choicebuilds/Kamii/README.md

# SumoBot v2
A significantly improved version of [SumoBot v1](https://github.com/choicebuilds/SumoBot-v1)!  Concise documentation intended as a project showcase for my portfolio/resume.
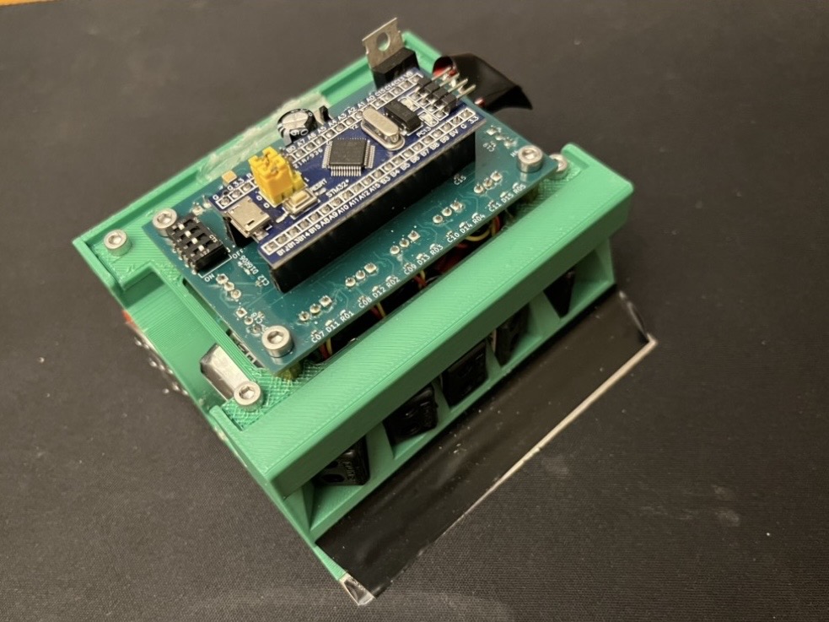
[picture p1: pictures/final_bot.jpg]
SumoBot
  
Notable Improvements:
- 4-layer PCB with dedicated 9V/5V planes and a solid ground plane to improve return current paths and help reduce EMI
- Decoupling & bulk capacitors placed throughout the board for improved power integrity
- STM32 MCU + STM32CubeMX + C/Cmake Firmware
- Various quality of life additions (e.g. strategy switch, remote start, on/off switch, etc.)
- Compact layout featuring 0402 surface-mount components (ft. dog-bone fanout for motor drivers for space and cost)
 
## Hardware Showcase
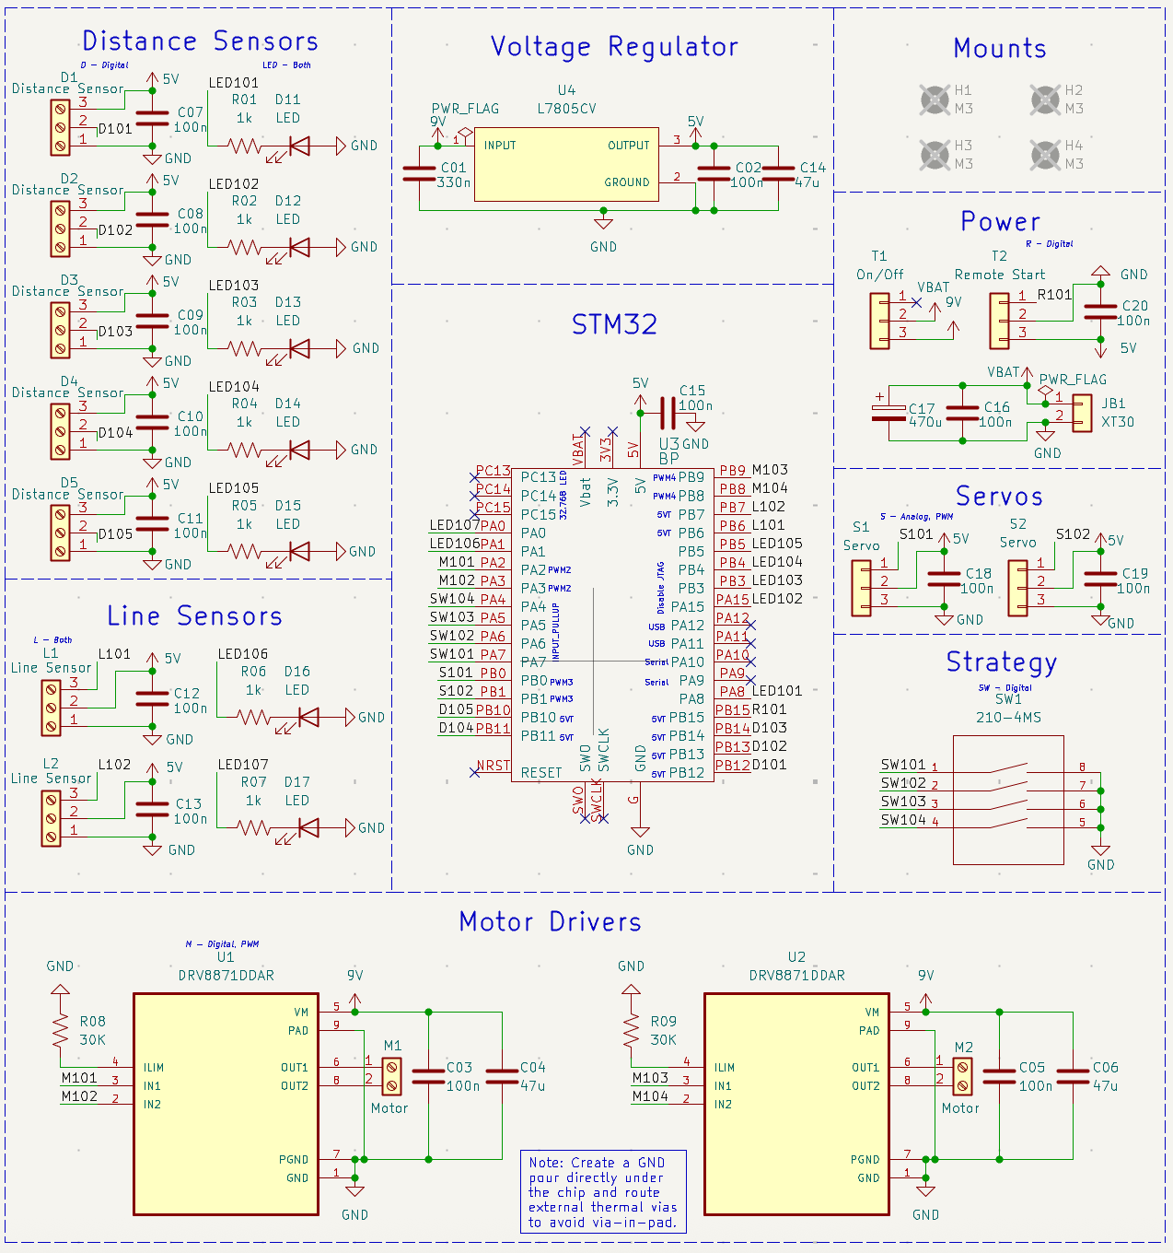
[picture p2: pictures/Kamikazii-Schematic.png]
Schematic


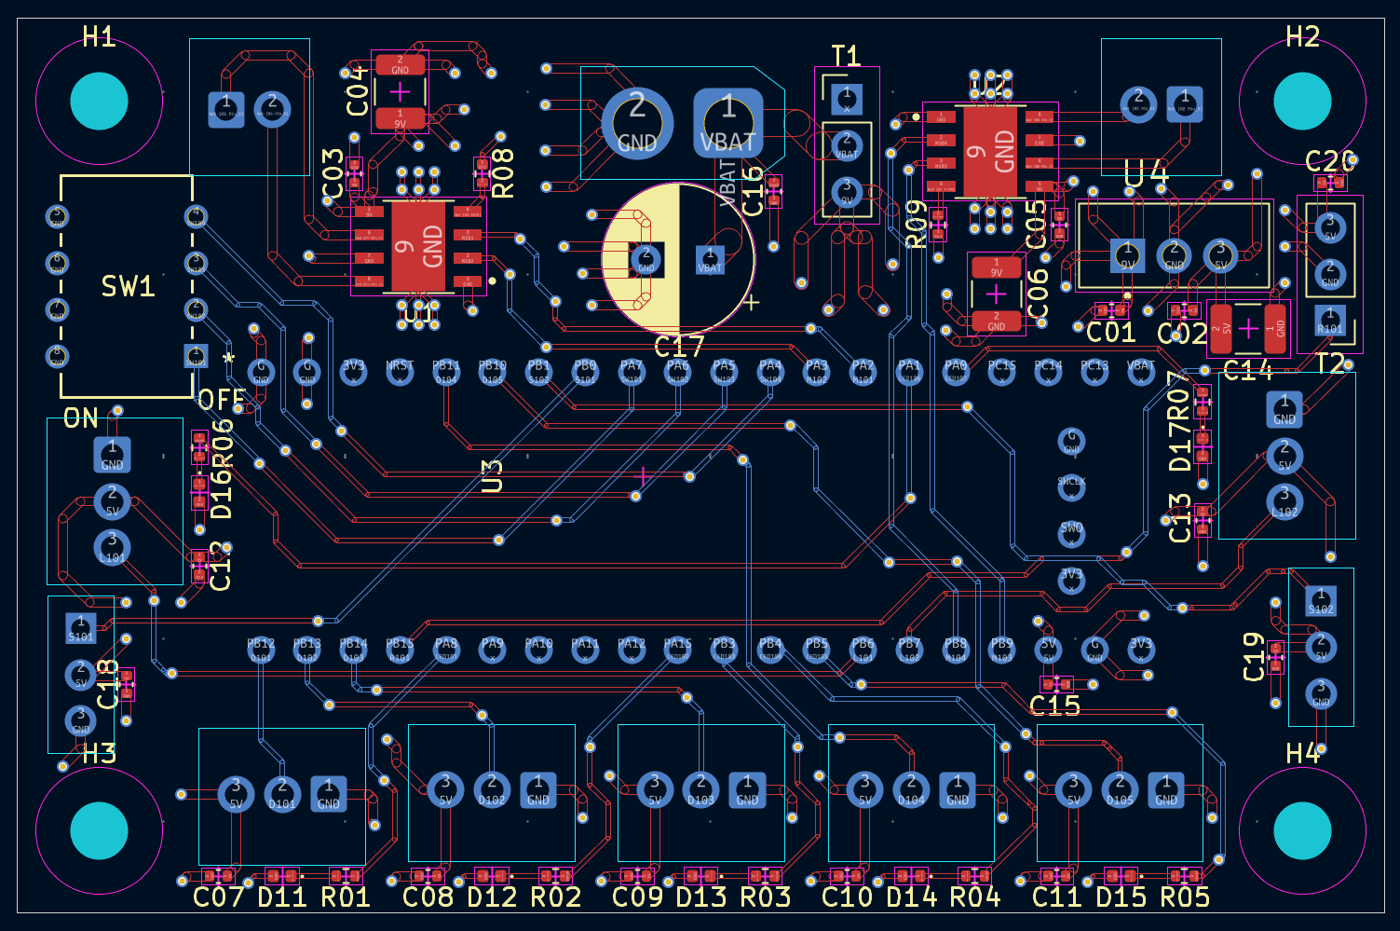
[picture p3: pictures/Kamikazii-Layout.png]
Layout


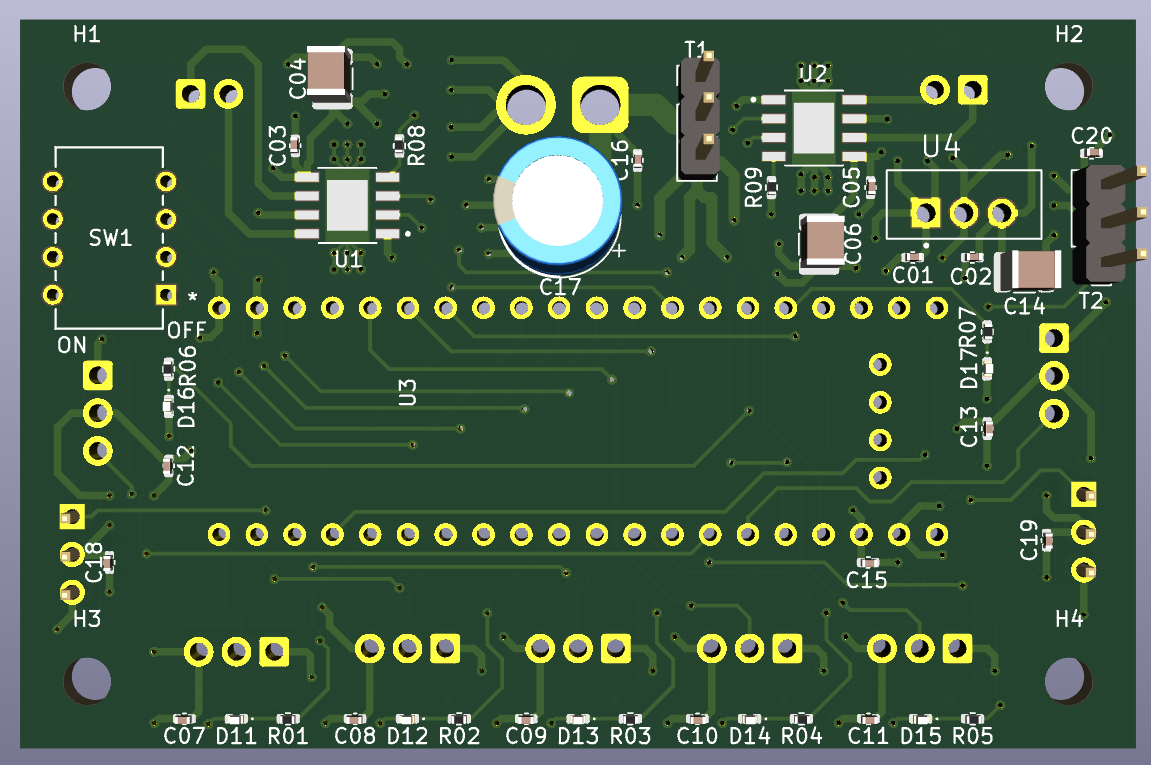
[picture p4: pictures/Kamikazii-Top.png]
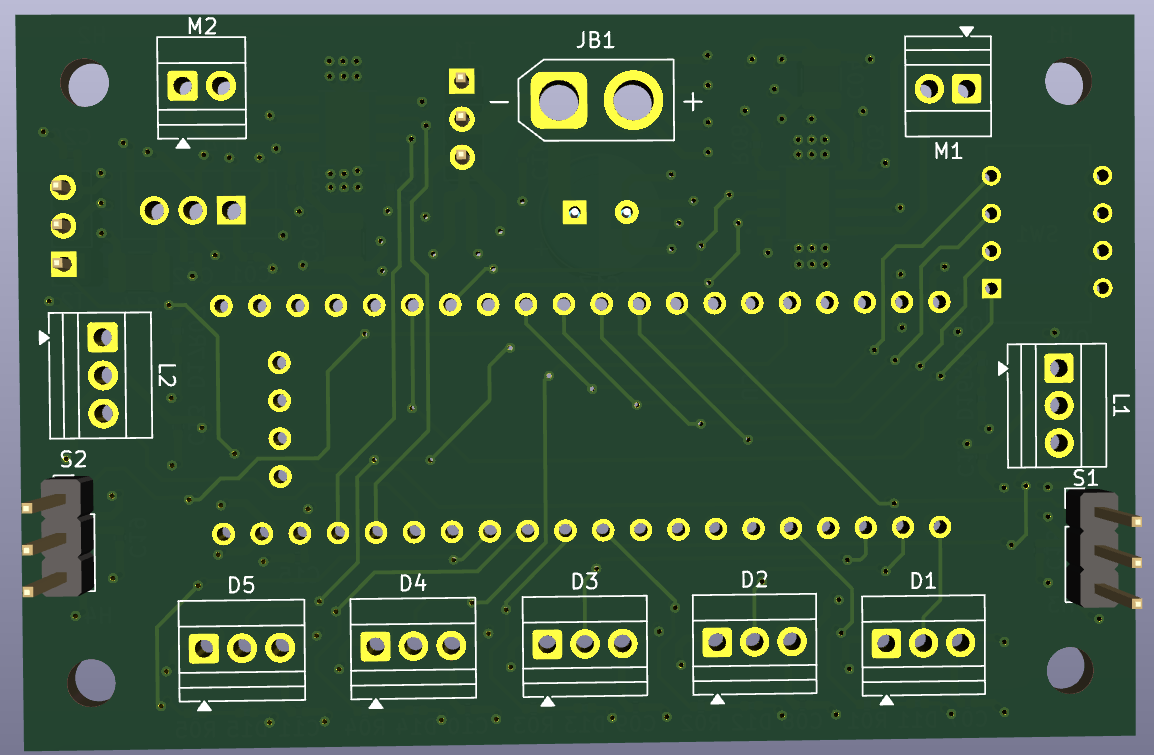
[picture p5: pictures/Kamikazii-Bottom.png]
Bottom
 

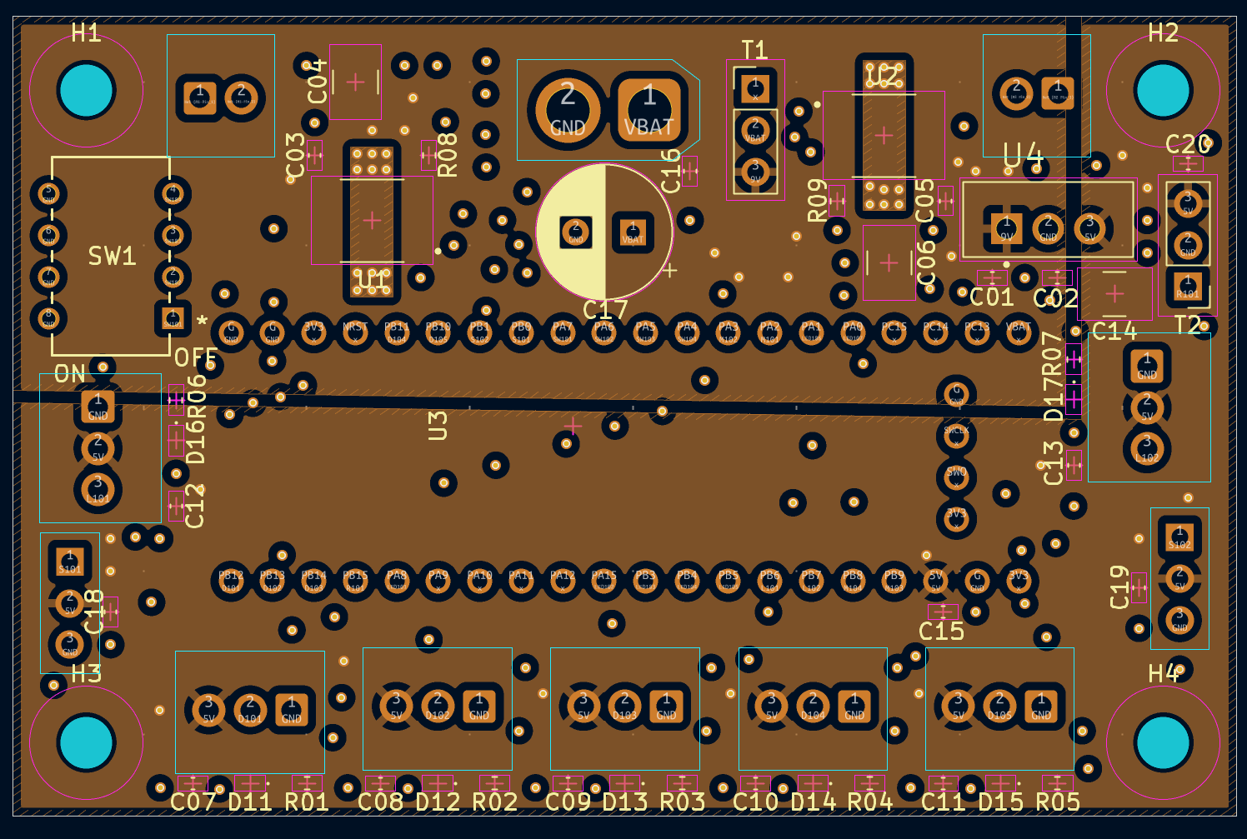
[picture p6: pictures/Kamikazii-Power-Planes.png]
Power-Planes
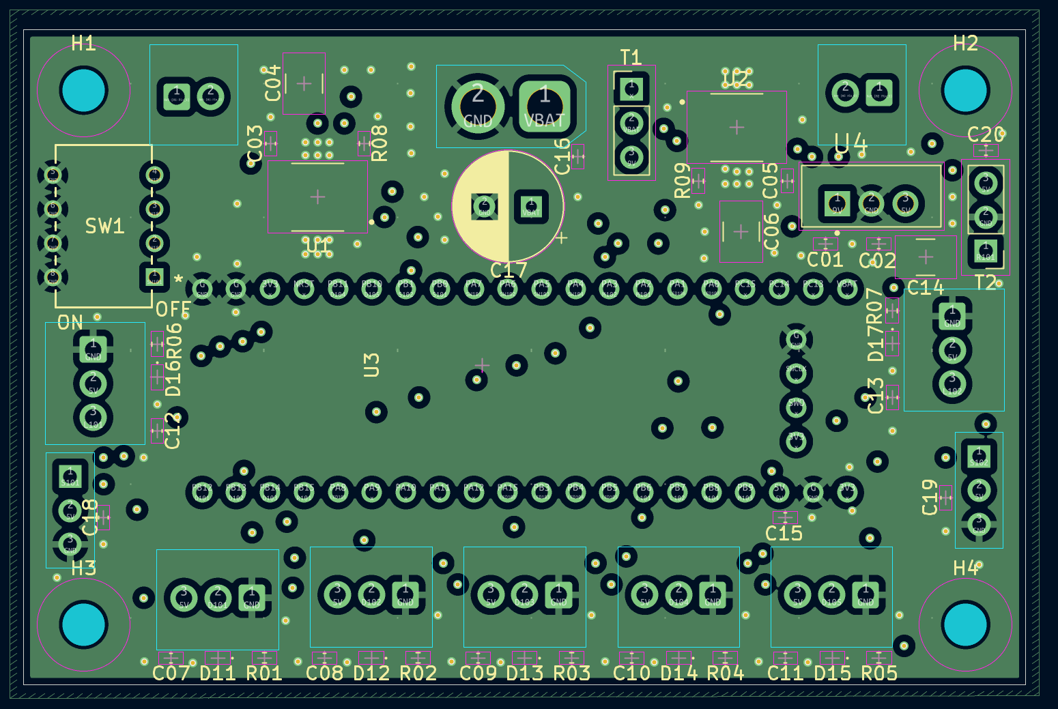
[picture p7: pictures/Kamikazii-Solid-GND-Plane.png]
Solid-GND-Plane
 

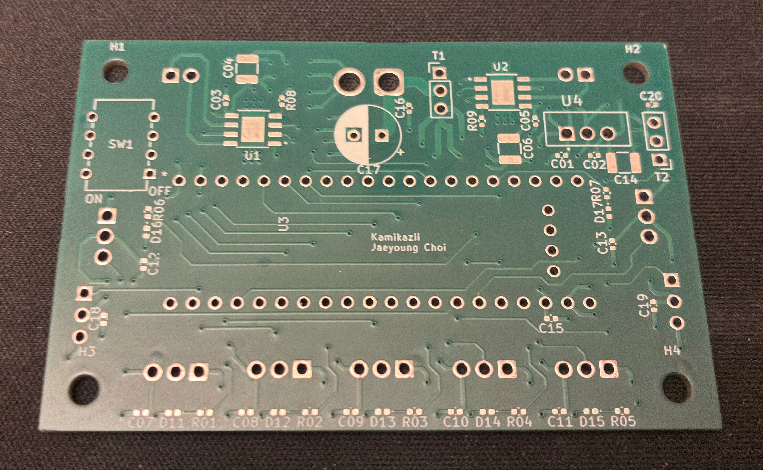
[picture p8: pictures/pcb_front.png]
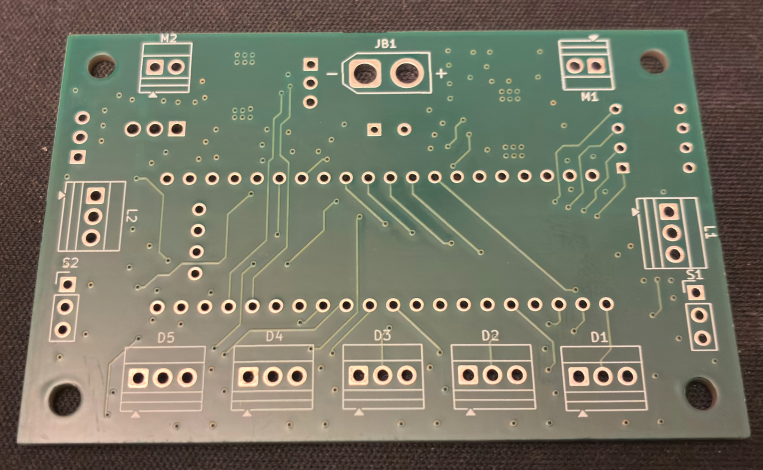
[picture p9: pictures/pcb_back.png]
 

## Soldering Showcase
With the JLCPCB Stencil: $14.16 (PCB) + $21.69 (Shipping) - $5 (Coupon) = $30.85 + Tax  
Without the JLCPCB Stencil: $7 (PCB) + $3.12 (Shipping) - $5 (Coupon) = $5.12 + Tax  
I went with the second option and generated a stencil using the LPKF Protolaser.  
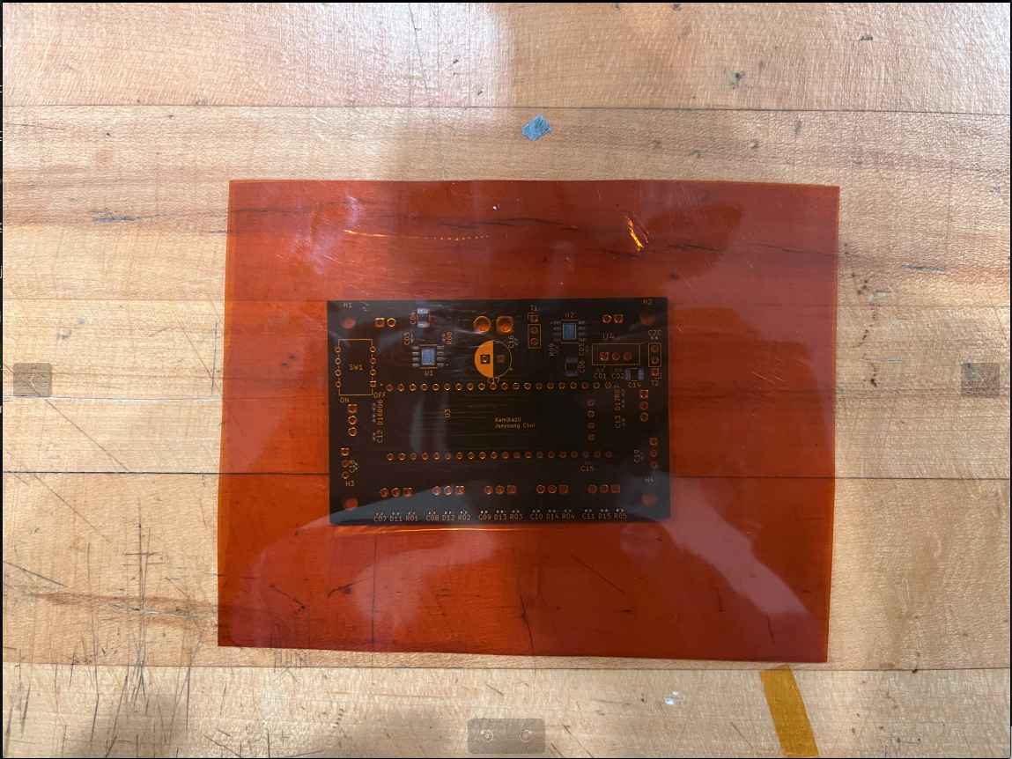
[picture p10: pictures/stencil_front.png]
Front of Stencil
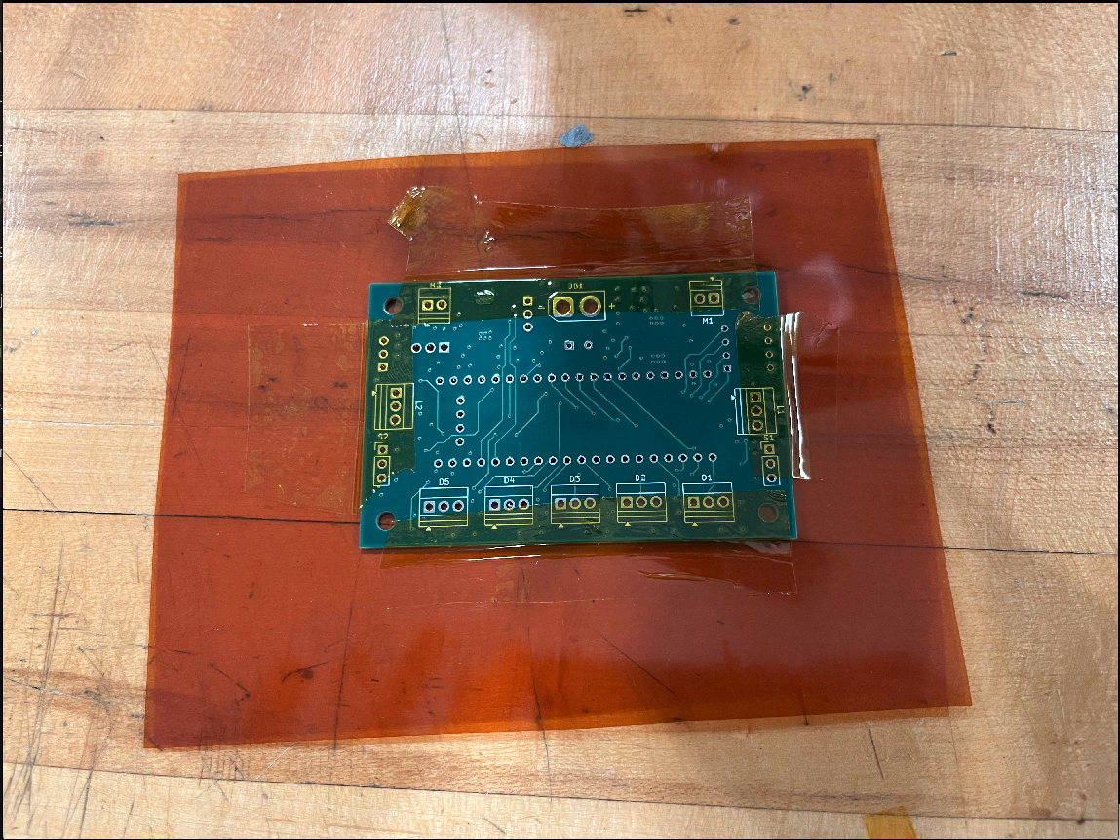
[picture p11: pictures/stencil_back.png]
Back of Stencil
   
I would not recommend, especially for a small PCB, because the stencil did not sit flat. Required a few manual adjustments.  
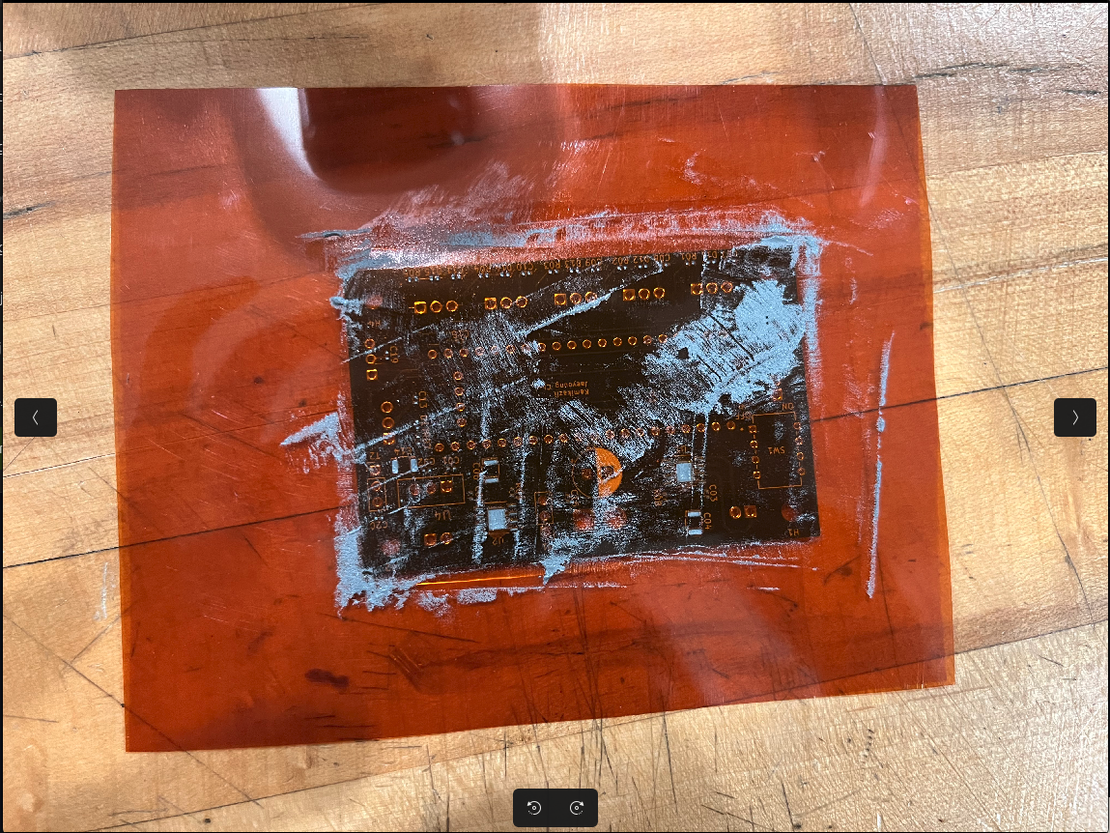
[picture p12: pictures/stencil_solder.png]
Solder Applied
  
Then, a reflow oven was used for SMD components:  
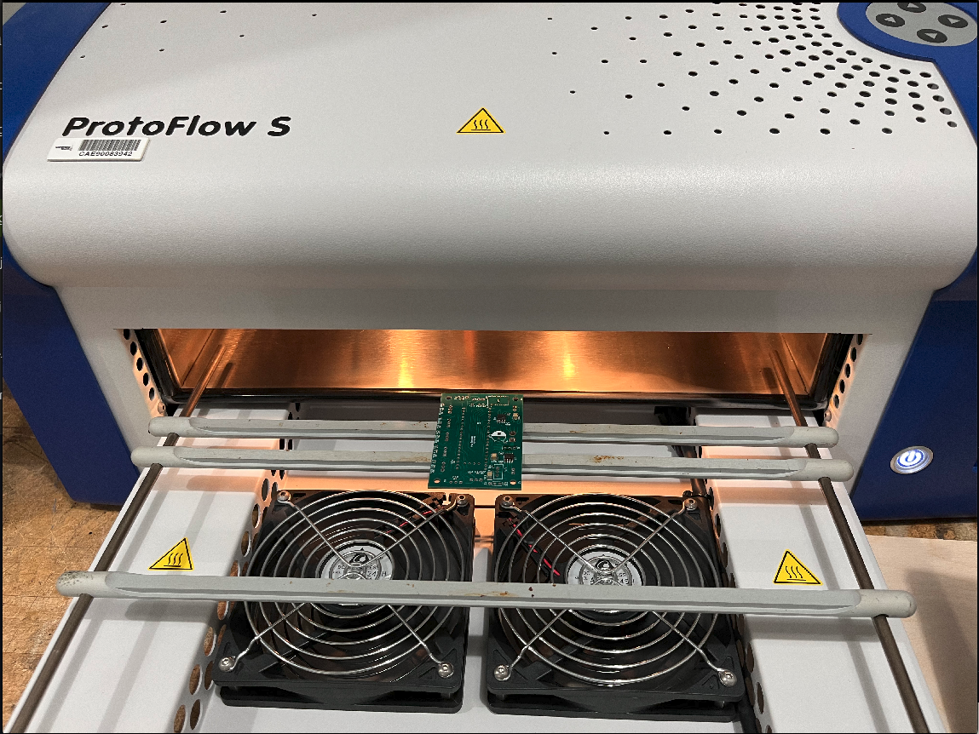
[picture p13: pictures/protoflow.png]
LPKF Protoflow
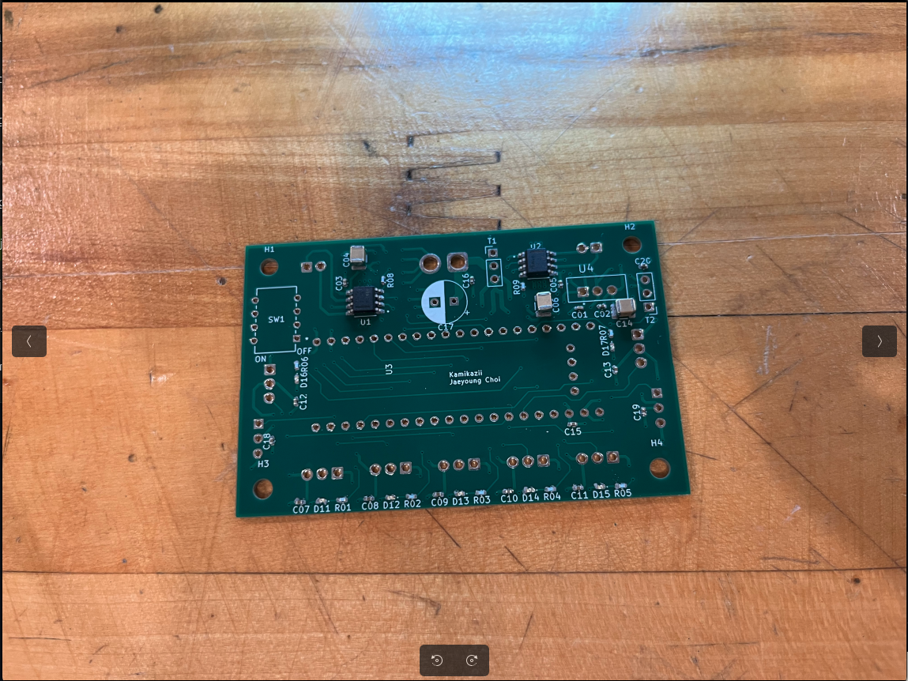
[picture p14: pictures/protoflow_2.png]
SMD Complete
   
And the remaining components were through-hole soldered.

## WARNING
I flipped the polarity of the XT-30 connector on the silkscreen without reverse-polarity protection:  
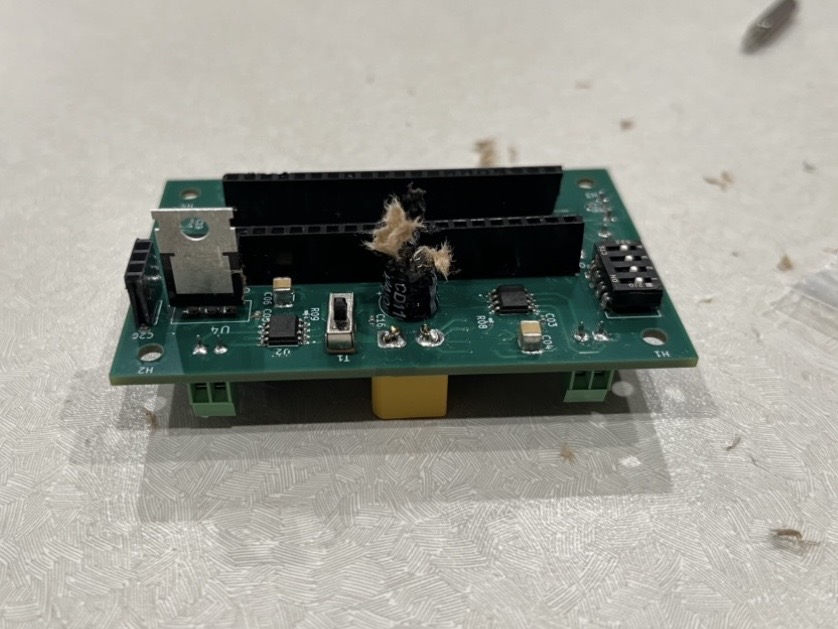
[picture p15: pictures/blown_capacitor.jpg]
Blown Up Capacitor
  
It made a very loud sound when the bulk capacitor blew up. Lesson learned to always double check.

## Demo Video
[](https://www.youtube.com/watch?v=7yXx8vgZZFc)
