choicebuilds/Kamii/hardware/Kamikazii.step

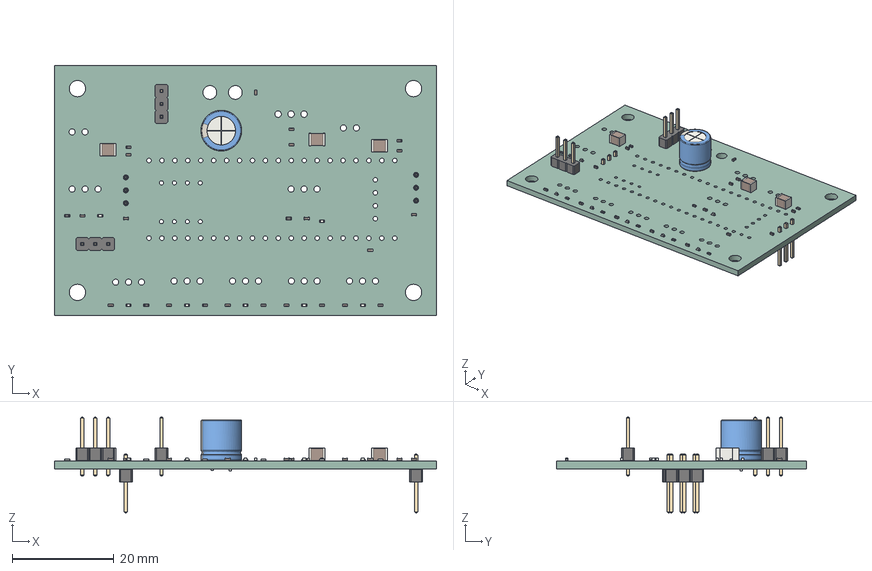
[picture p16: CAD file, 2026-01-21]
hardware/Kamikazii.step
75.0 x 49.0 x 18.8 mm
C_0402_1005Metric x 15
PinHeader_1x03_P2.54mm_Vertical x 4
LED_0402_1005Metric x 7
R_0402_1005Metric x 9
CP_Radial_D8.0mm_P3.50mm
C_1210_3225Metric x 3
Kamikazii_PCB
