choicebuilds/Kamii/hardware/symbols/DRV8871DDAR/DRV8871DDAR.step

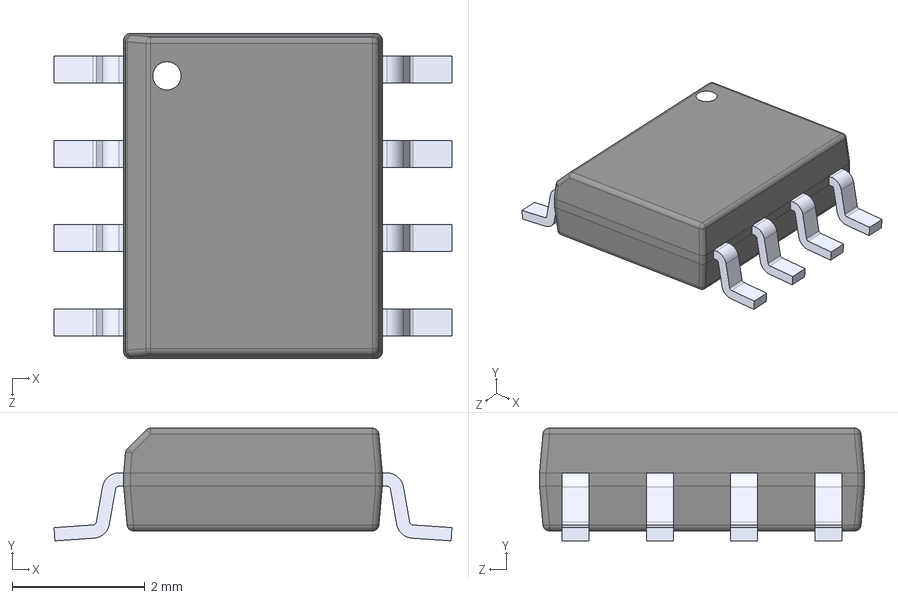
[picture p17: CAD file, 2026-01-19]
hardware/symbols/DRV8871DDAR/DRV8871DDAR.step
6.00 x 1.70 x 4.90 mm
