choicebuilds/Kamii/hardware/symbols/L7805CV/L7805CV.step

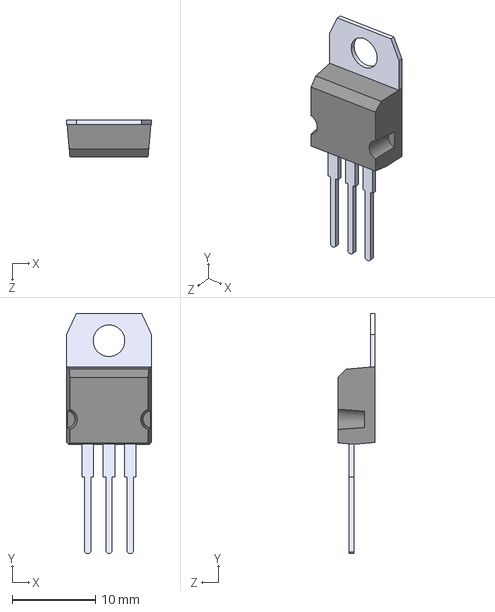
[picture p18: CAD file, 2026-01-19]
hardware/symbols/L7805CV/L7805CV.step
10.2 x 28.9 x 4.50 mm
