choicebuilds/Kamii/hardware/Kamikazii.kicad_pcb

## KiCad design hardware/Kamikazii.kicad_pcb (2026-01-24)

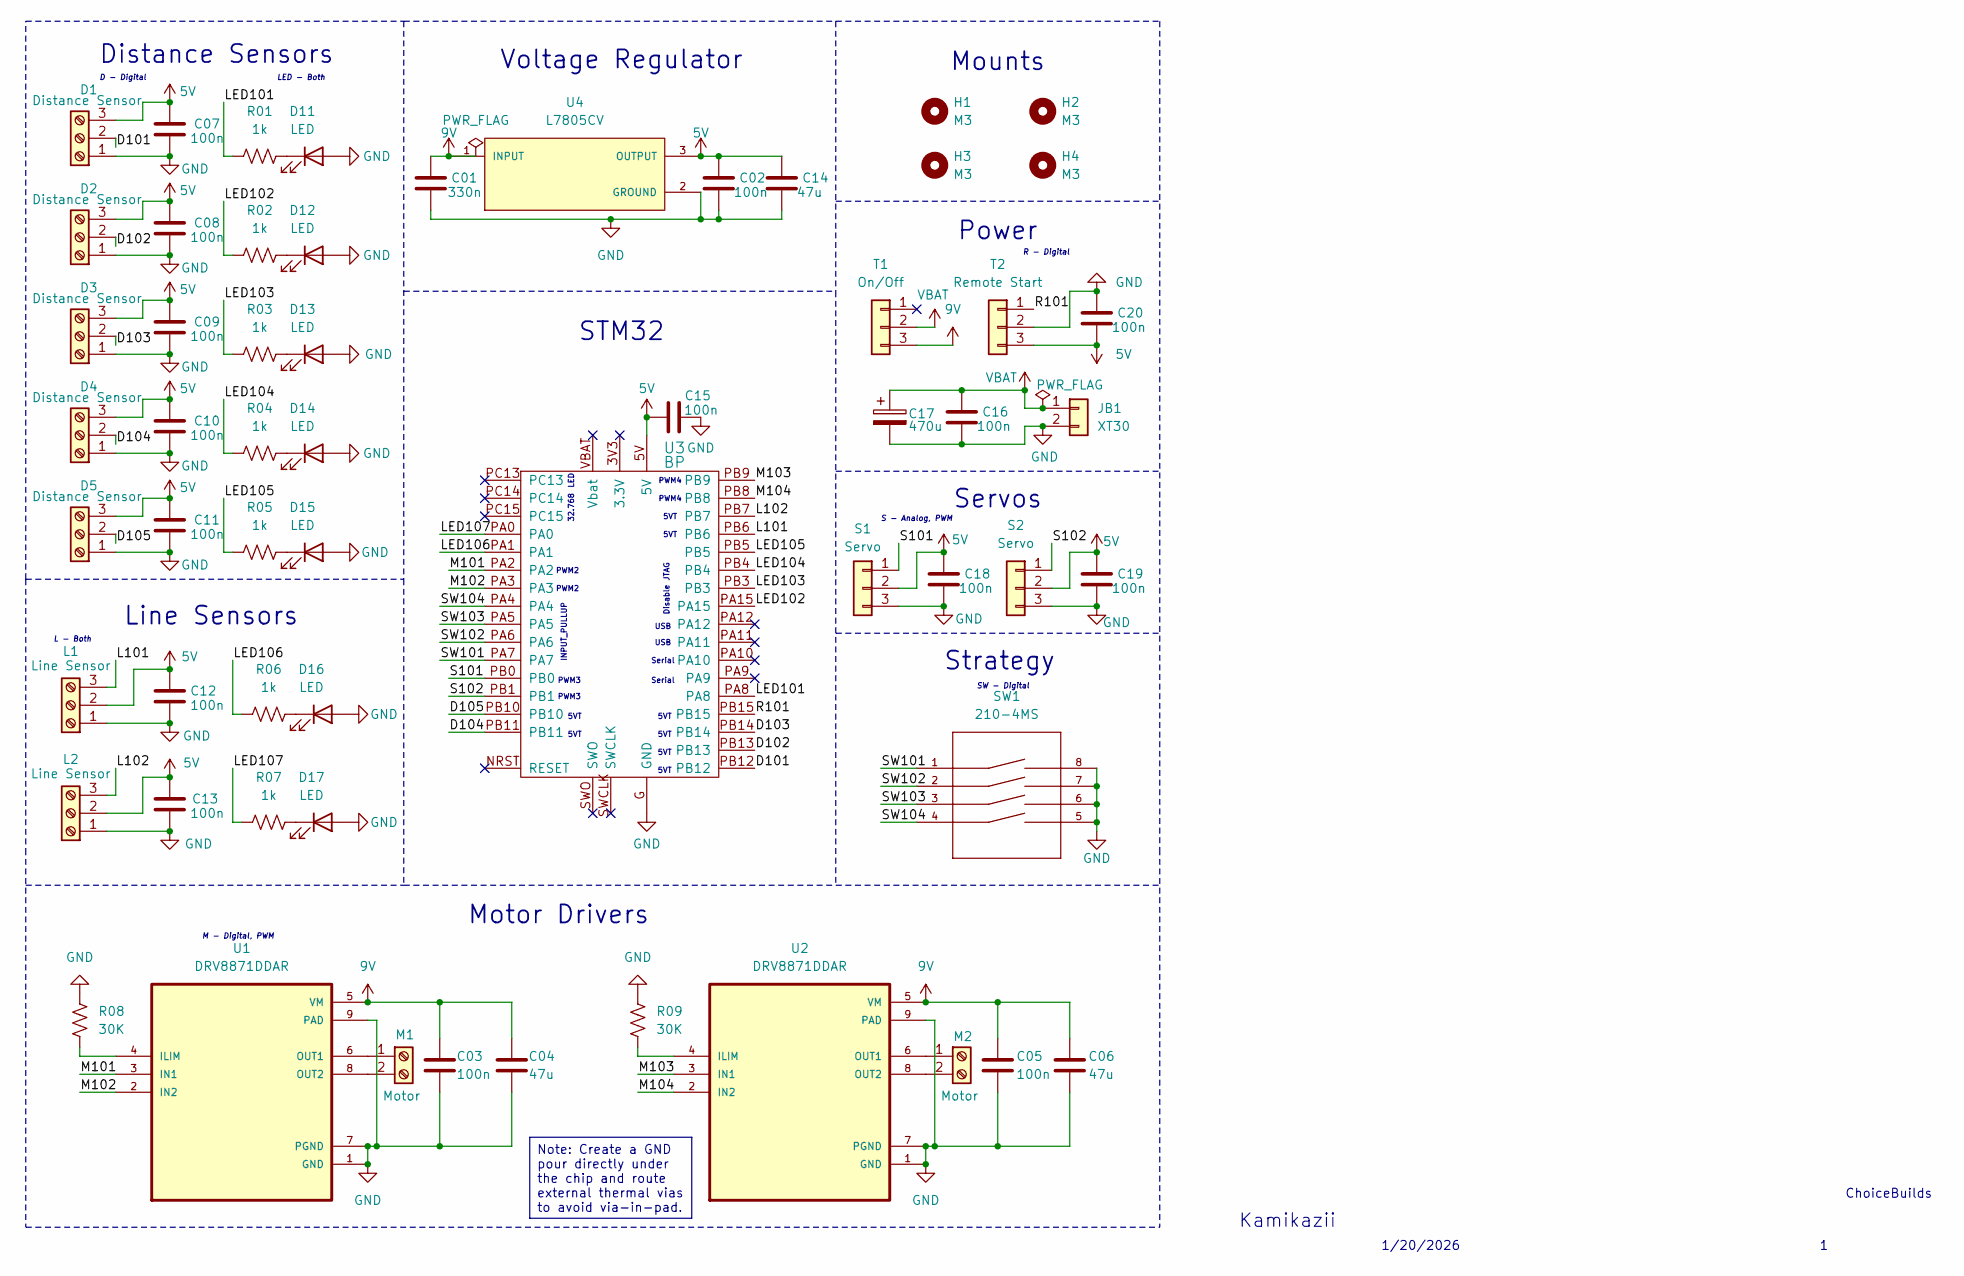
[picture p19: schematic Kamikazii.kicad_sch]

Parts:
C01: 330n; C_0402_1005Metric
C02, C03, C05, C07, C08, C09, C10, C11, C12, C13, C15, C16, C18, C19, C20: 100n; C_0402_1005Metric
C04, C06, C14: 47u; C_1210_3225Metric
C17: 470u; CP_Radial_D8.0mm_P3.50mm
D1, D2, D3, D4, D5: Distance Sensor; TerminalBlock_Xinya_XY308-2.54-3P_1x03_P2.54mm_Horizontal
D11, D12, D13, D14, D15, D16, D17: LED; LED_0402_1005Metric
H1, H2, H3, H4: M3; MountingHole_3.2mm_M3
JB1: XT30; AMASS_XT30U-F_1x02_P5.0mm_Vertical
L1, L2: Line Sensor; TerminalBlock_Xinya_XY308-2.54-3P_1x03_P2.54mm_Horizontal
M1, M2: Motor; TerminalBlock_Xinya_XY308-2.54-2P_1x02_P2.54mm_Horizontal
R01, R02, R03, R04, R05, R06, R07: 1k; R_0402_1005Metric
R08, R09: 30K; R_0402_1005Metric
S1, S2: Servo; PinHeader_1x03_P2.54mm_Vertical
SW1: 210-4MS; MANUFACTURER_PART_NUMBER 210-4MS
T1: On/Off; PinHeader_1x03_P2.54mm_Vertical
T2: Remote Start; PinHeader_1x03_P2.54mm_Vertical
U1, U2: DRV8871DDAR; VREG_LM5017MR_NOPB
U3: BP; blue_pill
U4: L7805CV; TO255P1040X460X1968-3; PARTREV 36

Connections:
5V: C02.2, C07.1, C08.1, C09.1, C10.1, C11.1, C12.1, C13.1, C14.2, C15.1, C18.2, C19.2, C20.1, D1.3, D2.3, D3.3, D4.3, D5.3, L1.2, L2.2, S1.2, S2.2, T2.3, U3.5V, U4.3 (OUTPUT)
9V: C01.2, C03.1, C04.1, C05.1, C06.1, T1.3, U1.5 (VM), U2.5 (VM), U4.1 (INPUT)
/D101: D1.2, U3.PB12
/D102: D2.2, U3.PB13
/D103: D3.2, U3.PB14
/D104: D4.2, U3.PB11
/D105: D5.2, U3.PB10
/L101: L1.3, U3.PB6
/L102: L2.3, U3.PB7
/LED101: R01.1, U3.PA8
/LED102: R02.1, U3.PA15
/LED103: R03.1, U3.PB3
/LED104: R04.1, U3.PB4
/LED105: R05.1, U3.PB5
/LED106: R06.1, U3.PA1
/LED107: R07.1, U3.PA0
/M101: U1.3 (IN1), U3.PA2
/M102: U1.2 (IN2), U3.PA3
/M103: U2.3 (IN1), U3.PB9
/M104: U2.2 (IN2), U3.PB8
/R101: T2.1, U3.PB15
/S101: S1.1, U3.PB0
/S102: S2.1, U3.PB1
/SW101: SW1.1, U3.PA7
/SW102: SW1.2, U3.PA6
/SW103: SW1.3, U3.PA5
/SW104: SW1.4, U3.PA4
GND: C01.1, C02.1, C03.2, C04.2, C05.2, C06.2, C07.2, C08.2, C09.2, C10.2, C11.2, C12.2, C13.2, C14.1, C15.2, C16.1, C17.2, C18.1, C19.1, C20.2, D1.1, D2.1, D3.1, D4.1, D5.1, D11.2 (A), D12.2 (A), D13.2 (A), D14.2 (A), D15.2 (A), D16.2 (A), D17.2 (A), JB1.2, L1.1, L2.1, R08.1, R09.1, S1.3, S2.3, SW1.5, SW1.6, SW1.7, SW1.8, T2.2, U1.1 (GND), U1.7 (PGND), U1.9 (PAD), U2.1 (GND), U2.7 (PGND), U2.9 (PAD), U3.G (GND), U4.2 (GROUND)
unnamed: D11.1 (K), R01.2
unnamed: D12.1 (K), R02.2
unnamed: D13.1 (K), R03.2
unnamed: D14.1 (K), R04.2
unnamed: D15.1 (K), R05.2
unnamed: D16.1 (K), R06.2
unnamed: D17.1 (K), R07.2
unnamed: M1.1, U1.6 (OUT1)
unnamed: M1.2, U1.8 (OUT2)
unnamed: M2.1, U2.6 (OUT1)
unnamed: M2.2, U2.8 (OUT2)
unnamed: R08.2, U1.4 (ILIM)
unnamed: R09.2, U2.4 (ILIM)
VBAT: C16.2, C17.1, JB1.1, T1.2

Notes on the sheet:
Power
Motor Drivers
INPUT_PULLUP
PWM3
32.768
5VT
PWM2
S - Analog, PWM
D - Digital
Kamikazii
L - Both
LED - Both
1/20/2026
Serial
PWM4
ChoiceBuilds
Mounts
SW - Digital
LED
R - Digital
Voltage Regulator
Servos
Line Sensors
Strategy
USB
Disable JTAG
STM32
Distance Sensors
M - Digital, PWM
Note: Create a GND pour directly under the chip and route external thermal vias to avoid via-in-pad.

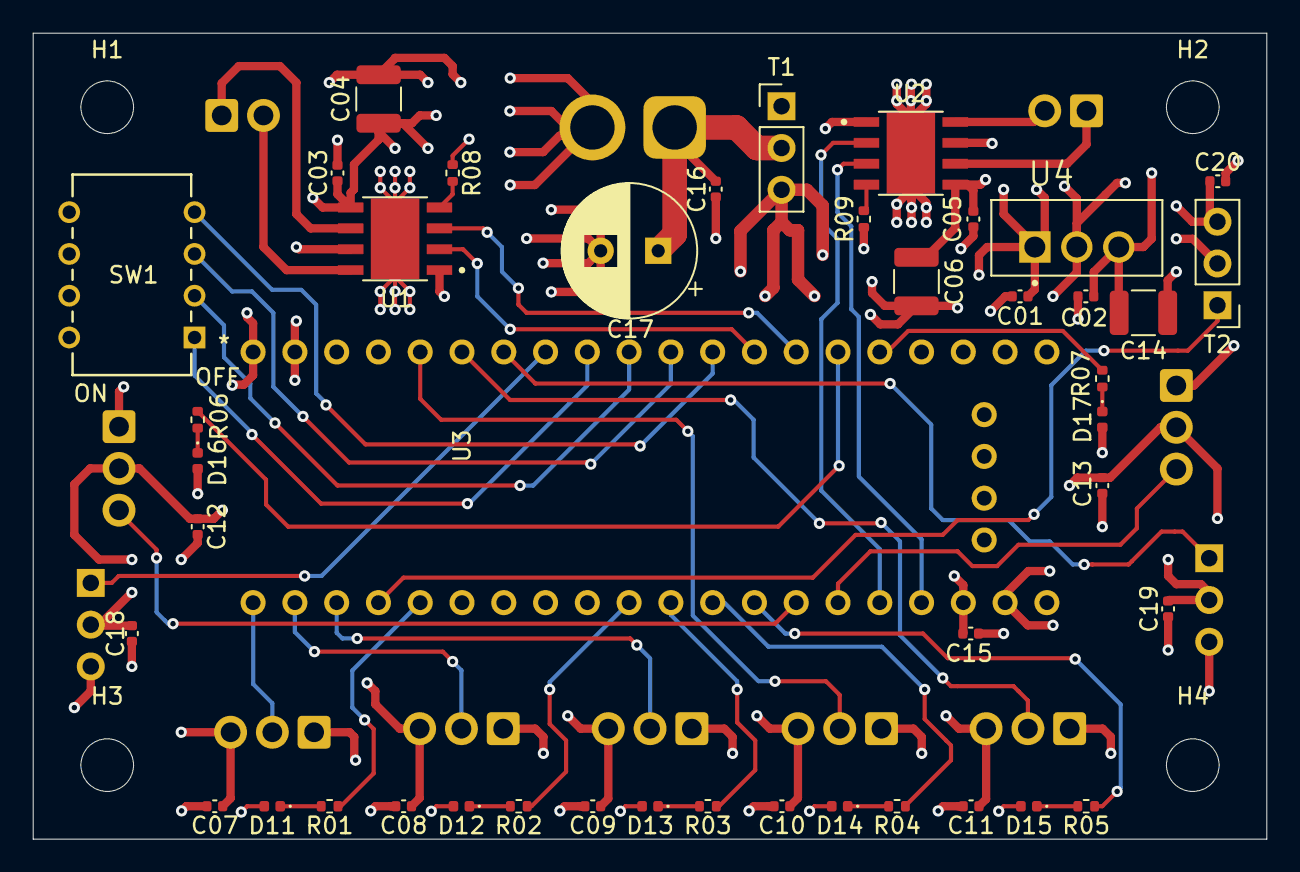
[picture p20: board Kamikazii.kicad_pcb from above]

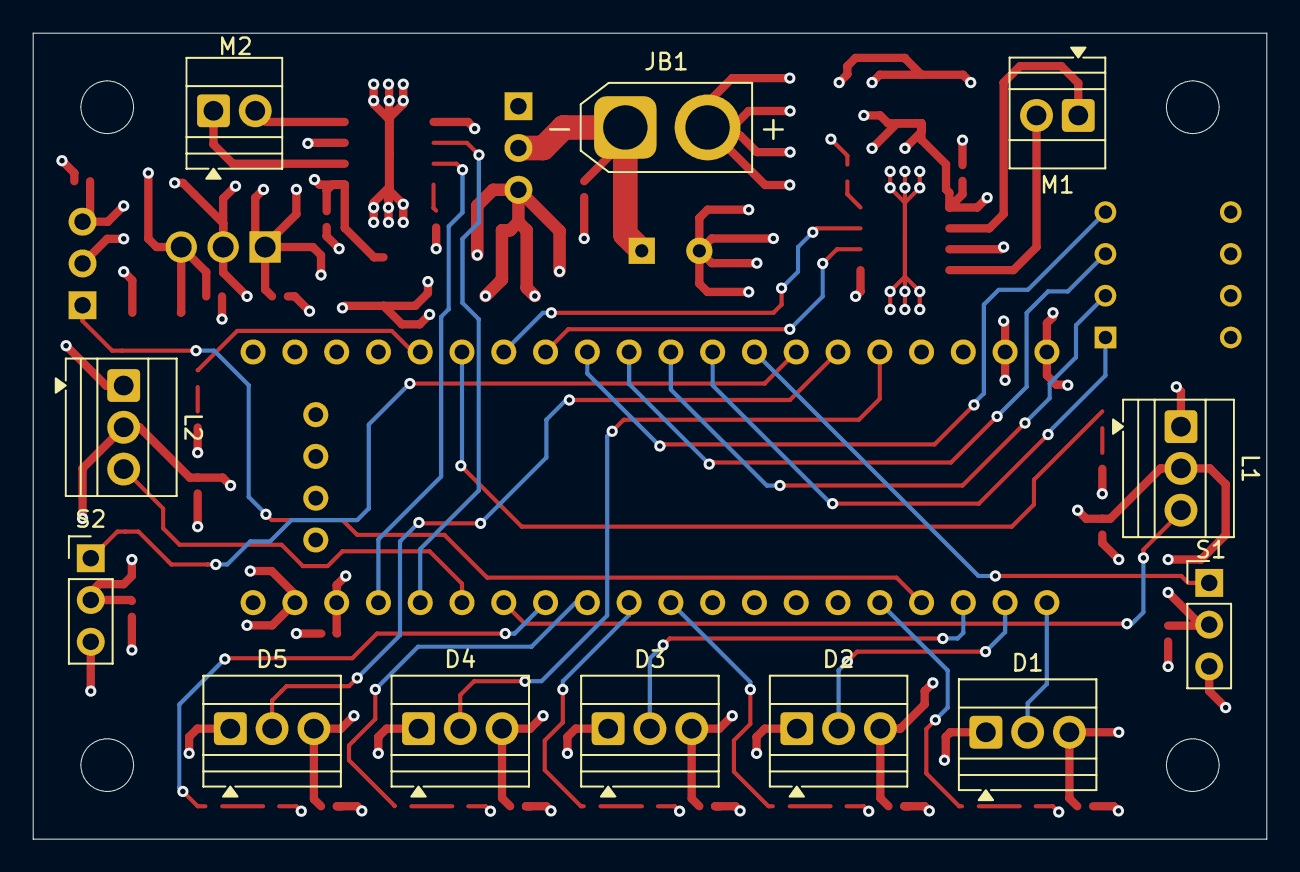
[picture p21: board Kamikazii.kicad_pcb from below]

Board: 4 copper layers, 75.0 x 49.0 mm, 59 parts (12 on the bottom side), 42 nets.
