choicebuilds/Kamii/(commit log)

2026-01-09 Dump Kamikazi files
    [Kamikazii.kicad_pcb, Kamikazii.kicad_sch]
2026-01-19 Add libraries for components
    [DRV8871DDAR.step, Kamikazii.kicad_sch, L7805CV.step]
2026-01-20 Finish schematic
    [Kamikazii.kicad_sch]
2026-01-20 Add more capacitors and pass ERC
    [Kamikazii.kicad_sch]
2026-01-21 Finalize schematic
    [Kamikazii.kicad_pcb, Kamikazii.kicad_sch]
2026-01-21 Start routing and fix minor schematic mistakes
    [JLCPCB.kicad_pcb, JLCPCB.sch, Kamikazii.kicad_pcb, Kamikazii.kicad_sch, Kamikazii.step]
2026-01-24 Make minor adjustments to schematic and finish layout with no errors
    [Kamikazii.kicad_pcb, Kamikazii.kicad_sch]
2026-01-24 Add pictures of PCB schematic, layouts, and 3D model
2026-01-27 Make cmake run on an ARM compiler
